dougsthenri/hub_usb_sd/README.md

# hub_usb_sd
PCB project for an SD card reader with 2-port USB hub and I²C bridge.

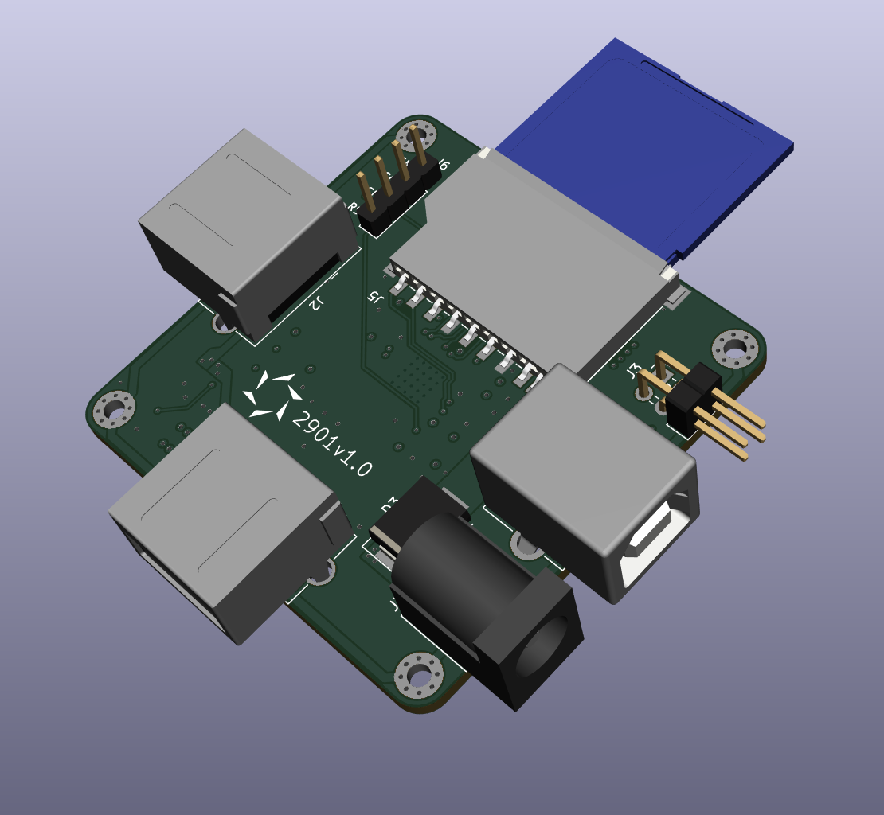
[picture p1: 2901.png]
PCB rendering
