dougsthenri/hub_usb_sd/hub_usb_sd.pdf

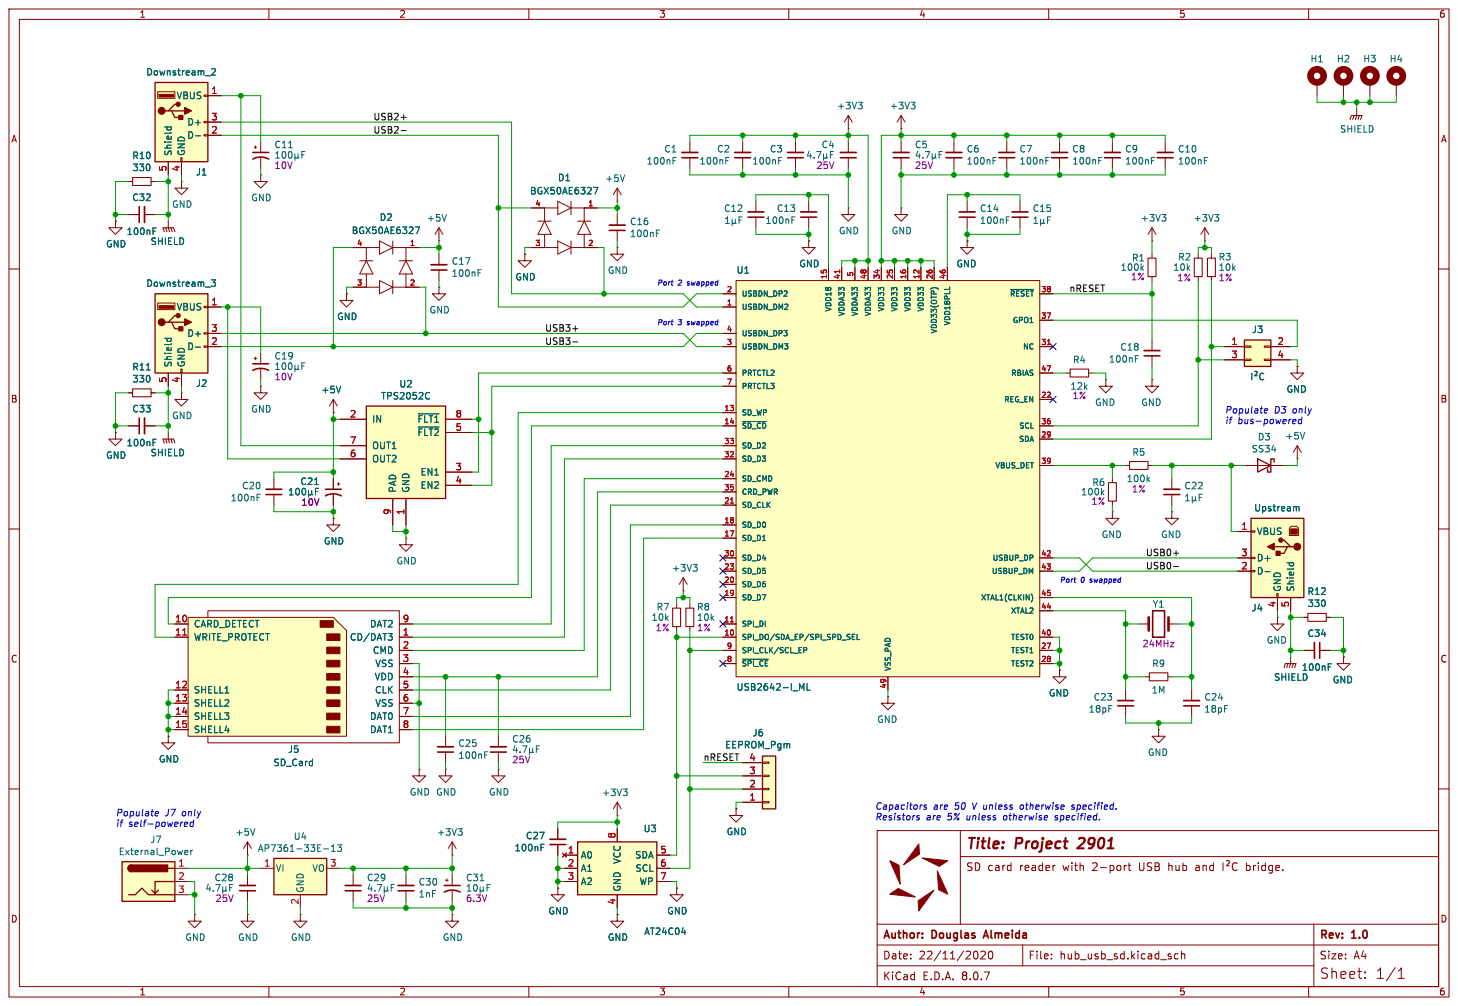
[picture p2: page 1]

4 SDA 5 SCL 6 WP 7 VCC
