dougsthenri/hub_usb_sd/hub_usb_sd.kicad_pcb

## KiCad design hub_usb_sd.kicad_pcb (2025-04-03)

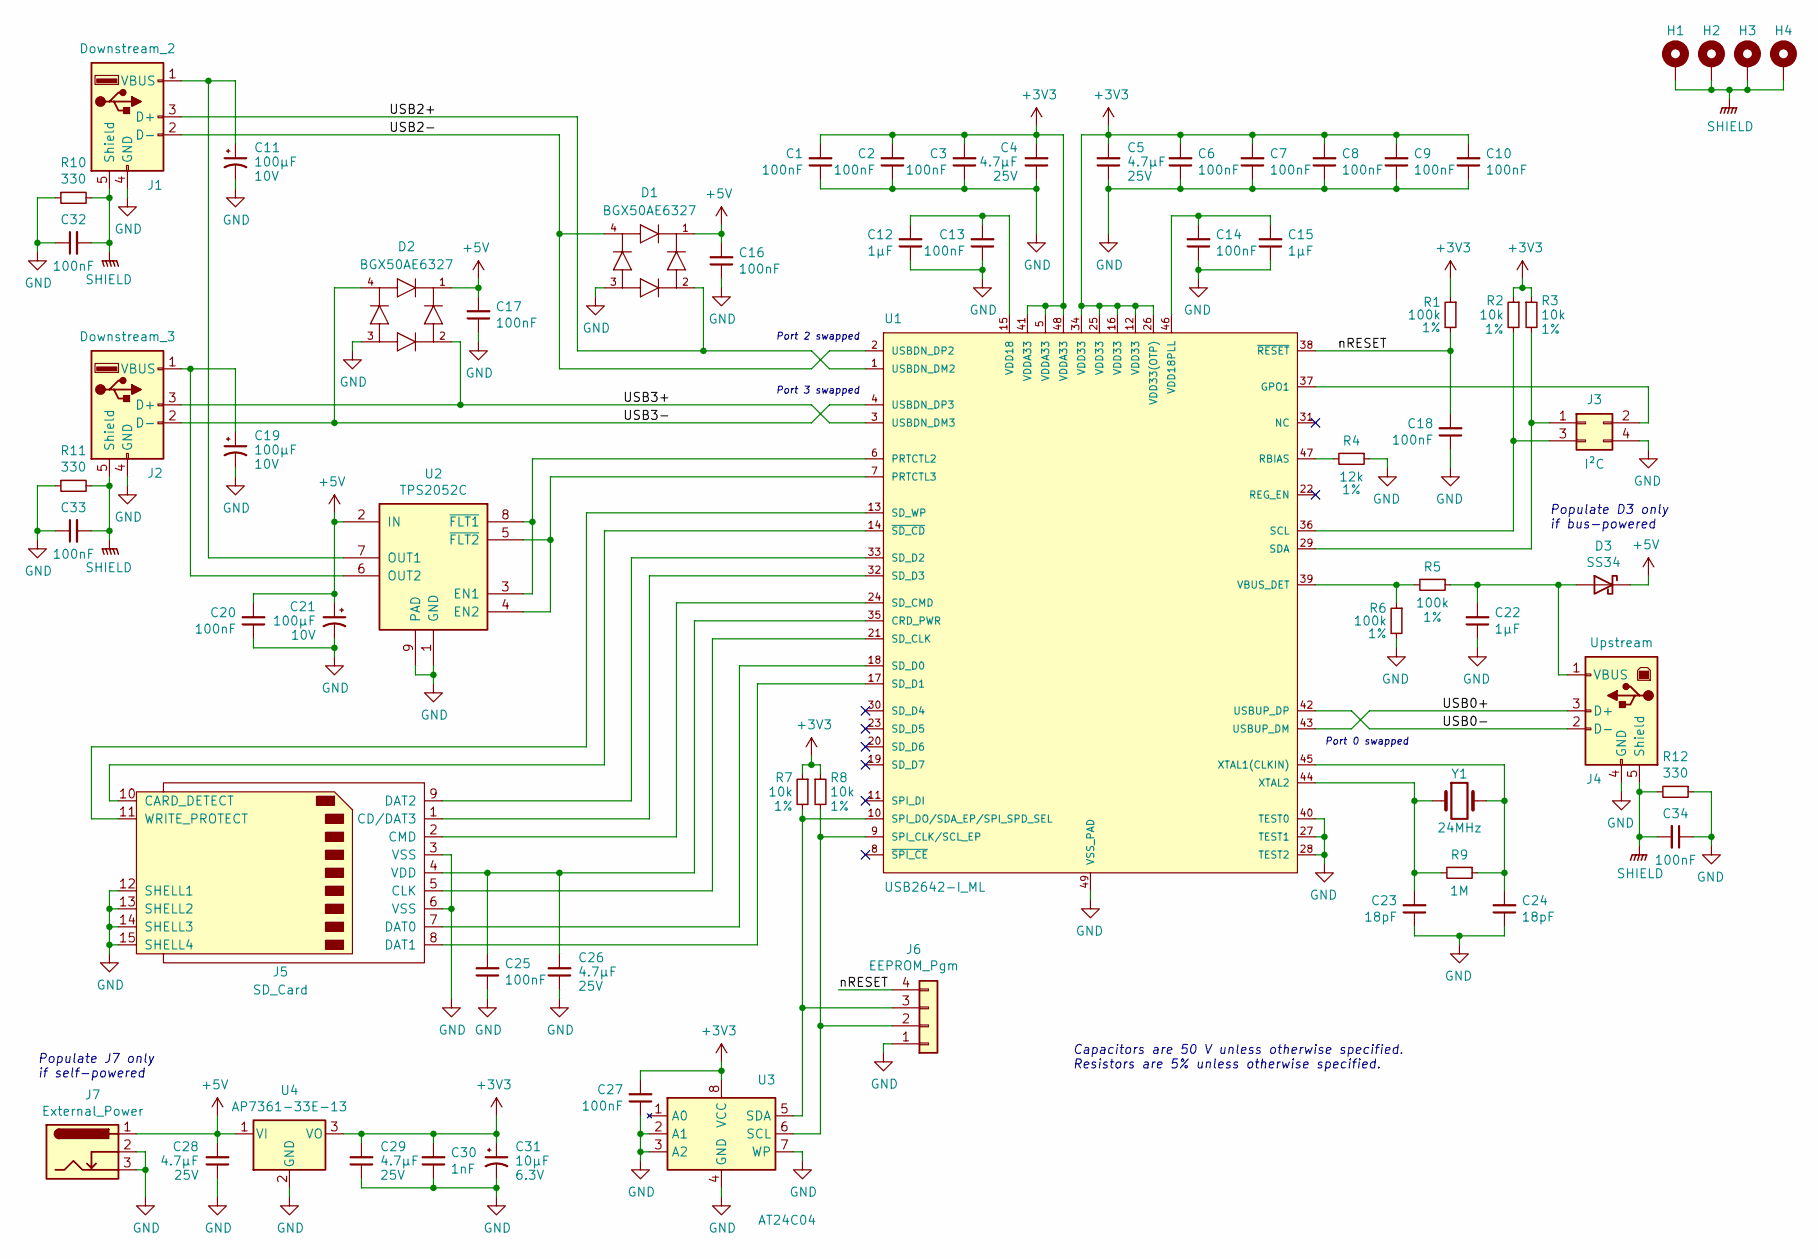
[picture p3: schematic hub_usb_sd.kicad_sch, Project 2901]

Parts:
C1, C2, C3, C6, C7, C8, C9, C10, C13, C14, C16, C17, C18, C20, C25, C27: 100nF; C_0805_2012Metric; Part# C0805C104K5RACTU
C4, C5, C26, C28, C29: 4.7µF; C_0805_2012Metric; Part# 08054,7UF25V
C11, C19, C21: 100µF; CP_EIA-3528-21_Kemet-B; Voltage 10V; Part# TMCMB1A107MTRF
C12, C15, C22: 1µF; C_0805_2012Metric; Part# 08051UF50V
C23, C24: 18pF; C_0603_1608Metric; Part# 060318PF50V
C30: 1nF; C_0603_1608Metric; Part# 06031NF50V
C31: 10µF; CP_EIA-3216-18_Kemet-A; Voltage 6.3V; Part# T491A106K006AT
C32, C33, C34: 100nF; C_0603_1608Metric; Part# 0603100NF50V
D1, D2: BGX50AE6327; Part# BGX 50A E6327
D3: SS34; D_SMC; Part# SS34
H1, H2, H3, H4: MountingHole_Pad; MountingHole_2.2mm_M2_Pad_Via
J1: Downstream_2; AF90_protruded_6_mm; Part# AF90
J2: Downstream_3; AF90_protruded_6_mm; Part# AF90
J3: I²C; PinHeader_2x02_P2.54mm_Horizontal_protruded_6_mm
J4: Upstream; USB_B_OST_USB-B1HSxx_Horizontal_Protruded_6_mm; Part# YH-USB03
J5: SD_Card; GCT_MEM1055-00-280-01-B; Part# 1138022
J6: EEPROM_Pgm; PinHeader_1x04_P2.54mm_Vertical
J7: External_Power; BarrelJack_DC-005_protruded_6_mm; Part# DC-005
R1, R5, R6: 100k; R_0805_2012Metric; Tolerance 1%; Part# CRCW0805100KFKEA
R2, R3, R7, R8: 10k; R_0805_2012Metric; Part# 08051%10K
R4: 12k; R_0805_2012Metric; Part# MC0805WAF1202T5E-TC
R9: 1M; R_0603_1608Metric; Part# 0603-1MOHM
R10, R11, R12: 330; R_0603_1608Metric; Part# 0603-330OHMS
U1: USB2642-I_ML; Microchip_USB2642-I_ML; Part# USB2642-I/ML-SEU
U2: TPS2052C; TI_DGN0008G; Part# TPS2052CDGNR
U3: AT24C04; Atmel_AT24C04BN; Part# AT24C04N-10SU-2.7
U4: AP7361-33E-13; SOT-223-3_TabPin2; Part# AP7361-33E-13
Y1: XRCGB24M000F0L00R0; Murata_XRCGB24M000F0L00R0; Part# XRCGB24M000F0L00R0

Connections:
+3V3: C1.2, C2.2, C3.2, C4.2, C5.2, C6.2, C7.2, C8.2, C9.2, C10.2, C27.2, C29.2, C30.2, C31.1, R1.1, R2.1, R3.1, R7.1, R8.1, U1.5 (VDDA33), U1.12 (VDD33), U1.16 (VDD33), U1.25 (VDD33), U1.26 (VDD33(OTP)), U1.34 (VDD33), U1.41 (VDDA33), U1.48 (VDDA33), U3.8 (VCC), U4.3 (VO)
+5V: C16.2, C17.2, C20.2, C21.1, C28.2, D1.1, D2.1, D3.1 (K), J7.1, U2.2 (IN), U4.1 (VI)
/USB0+: J4.3 (D+), U1.43 (USBUP_DM)
/USB0-: J4.2 (D-), U1.42 (USBUP_DP)
/USB2+: D1.2, J1.3 (D+), U1.1 (USBDN_DM2)
/USB2-: D1.4, J1.2 (D-), U1.2 (USBDN_DP2)
/USB3+: D2.2, J2.3 (D+), U1.3 (USBDN_DM3)
/USB3-: D2.4, J2.2 (D-), U1.4 (USBDN_DP3)
/nRESET: C18.2, J6.4, R1.2, U1.38 (~RESET)
GND: C1.1, C2.1, C3.1, C4.1, C5.1, C6.1, C7.1, C8.1, C9.1, C10.1, C11.2, C12.1, C13.1, C14.1, C15.1, C16.1, C17.1, C18.1, C19.2, C20.1, C21.2, C22.1, C23.1, C24.1, C25.1, C26.1, C27.1, C28.1, C29.1, C30.1, C31.2, C32.1, C33.1, C34.1, D1.3, D2.3, J1.4 (GND), J2.4 (GND), J3.4, J4.4 (GND), J5.3 (VSS), J5.6 (VSS), J5.12 (SHELL1), J5.13 (SHELL2), J5.14 (SHELL3), J5.15 (SHELL4), J6.1, J7.2, J7.3, R4.1, R6.2, R10.1, R11.1, R12.1, U1.27 (TEST1), U1.28 (TEST2), U1.40 (TEST0), U1.49 (VSS_PAD), U2.1 (GND), U2.9 (PAD), U3.2 (A1), U3.3 (A2), U3.4 (GND), U3.7 (WP), U4.2 (GND)
unnamed: C22.2, D3.2 (A), J4.1 (VBUS), R5.1
unnamed: C11.1, J1.1 (VBUS), U2.7 (OUT1)
unnamed: C19.1, J2.1 (VBUS), U2.6 (OUT2)
unnamed: J3.1, R3.2, U1.29 (SDA)
unnamed: J3.2, U1.37 (GPO1)
unnamed: J3.3, R2.2, U1.36 (SCL)
unnamed: J5.10 (CARD_DETECT), U1.14 (~SD_CD)
unnamed: J5.1 (CD/DAT3), U1.32 (SD_D3)
unnamed: J5.5 (CLK), U1.21 (SD_CLK)
unnamed: J5.2 (CMD), U1.24 (SD_CMD)
unnamed: J5.7 (DAT0), U1.18 (SD_D0)
unnamed: J5.8 (DAT1), U1.17 (SD_D1)
unnamed: J5.9 (DAT2), U1.33 (SD_D2)
unnamed: C25.2, C26.2, J5.4 (VDD), U1.35 (CRD_PWR)
unnamed: J5.11 (WRITE_PROTECT), U1.13 (SD_WP)
unnamed: J6.2, R8.2, U1.9 (SPI_CLK/SCL_EP), U3.6 (SCL)
unnamed: J6.3, R7.2, U1.10 (SPI_DO/SDA_EP/SPI_SPD_SEL), U3.5 (SDA)
unnamed: U1.6 (PRTCTL2), U2.3 (EN1), U2.8 (~FLT1)
unnamed: U1.7 (PRTCTL3), U2.4 (EN2), U2.5 (~FLT2)
unnamed: R4.2, U1.47 (RBIAS)
unnamed: R5.2, R6.1, U1.39 (VBUS_DET)
unnamed: C12.2, C13.2, U1.15 (VDD18)
unnamed: C14.2, C15.2, U1.46 (VDD18PLL)
unnamed: C24.2, R9.1, U1.45 (XTAL1(CLKIN)), Y1.3 (Crystal_terminal)
unnamed: C23.2, R9.2, U1.44 (XTAL2), Y1.1 (Crystal_terminal)
SHIELD: C32.2, C33.2, C34.2, H1.1, H2.1, H3.1, H4.1, J1.5 (Shield), J2.5 (Shield), J4.5 (Shield), R10.2, R11.2, R12.2

Notes on the sheet:
Port 0 swapped
Capacitors are 50 V unless otherwise specified. Resistors are 5% unless otherwise specified.
Port 3 swapped
Port 2 swapped
Populate D3 only if bus-powered
Populate J7 only if self-powered

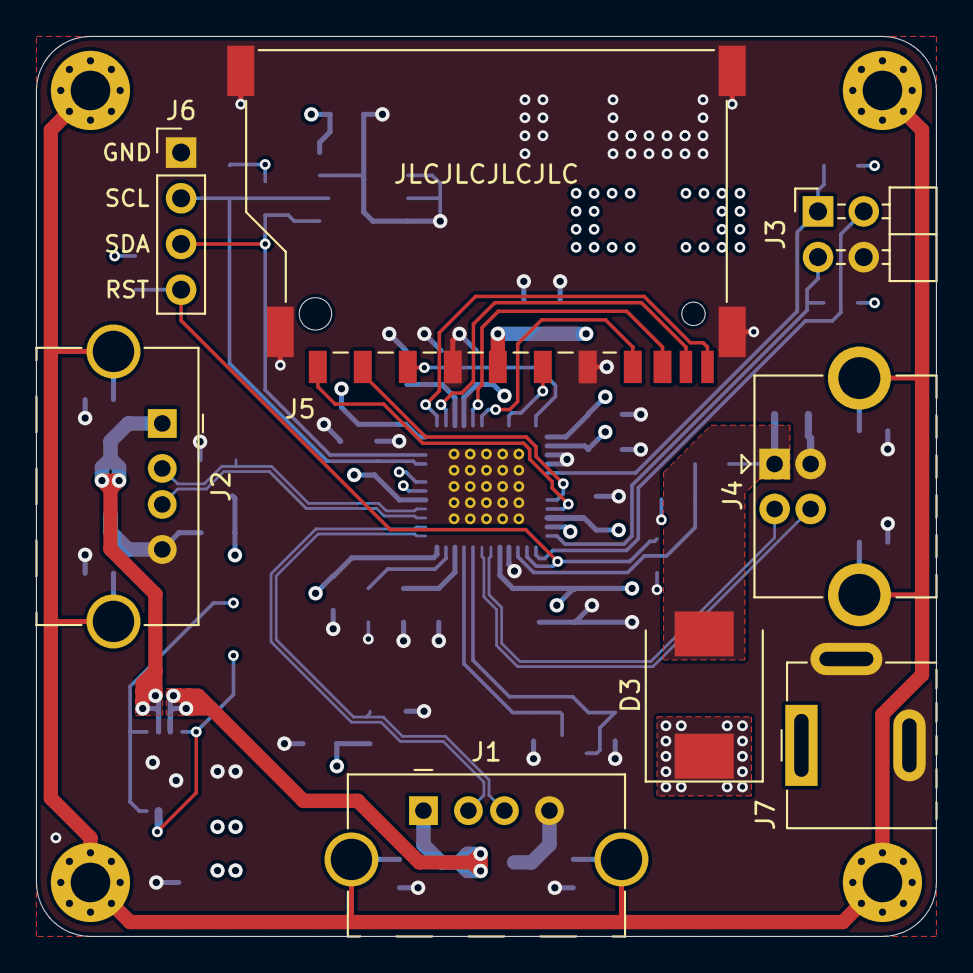
[picture p4: board hub_usb_sd.kicad_pcb from above]

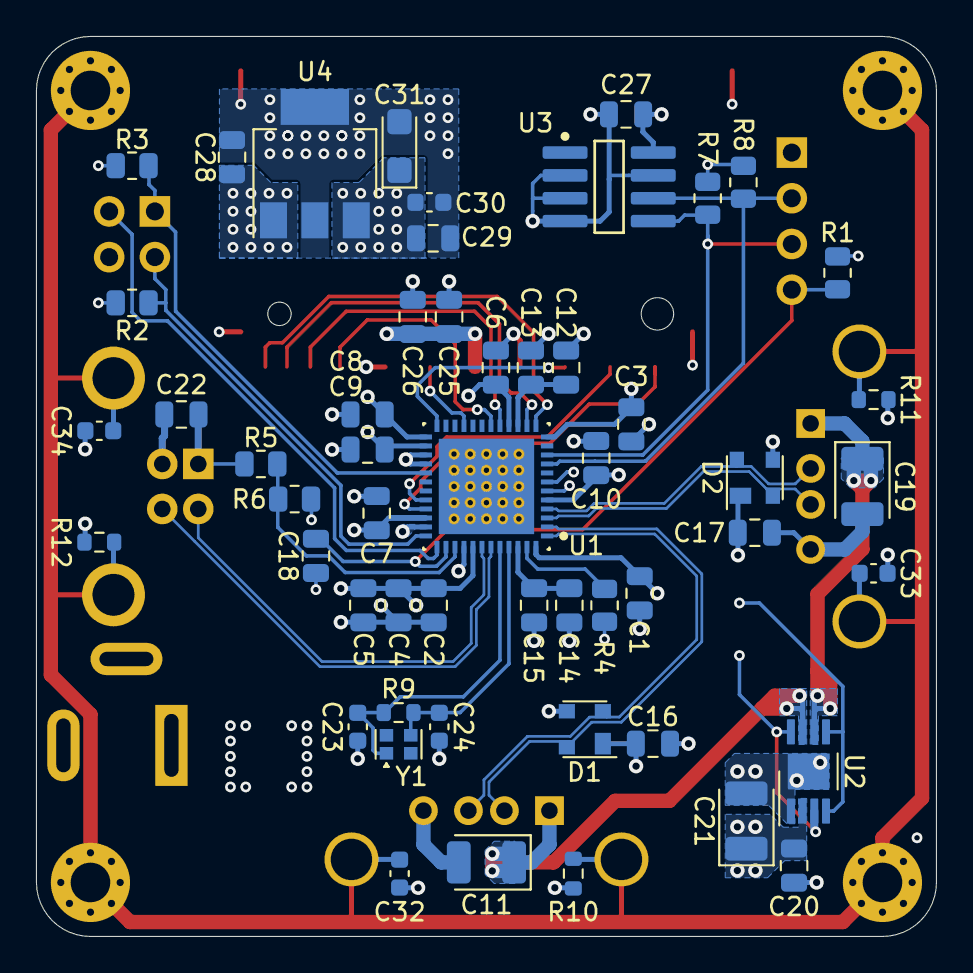
[picture p5: board hub_usb_sd.kicad_pcb from below]

Board: 4 copper layers, 50.0 x 50.0 mm, 65 parts (53 on the bottom side), 36 nets.
