dougsthenri/hub_usb_sd/(commit log)

2020-12-19 Added production remarks to schematic
    [hub_usb_sd.sch]
2020-12-20 Improved ground plane under U2 and corrected the positioning of C32-34
    [hub_usb_sd.kicad_pcb]
2020-12-21 Updated board layout to accommodate new power supply connector
    [hub_usb_sd-B_Cu.gbr, hub_usb_sd-B_Mask.gbr, hub_usb_sd-B_Paste.gbr, hub_usb_sd-B_SilkS.gbr, hub_usb_sd-Edge_Cuts.gbr, hub_usb_sd-F_Cu.gbr, hub_usb_sd-F_Mask.gbr, hub_usb_sd-F_Paste.gbr]
2020-12-21 Optimized trace under C18
    [hub_usb_sd.kicad_pcb]
2024-03-12 Upgraded project to Kicad 8.0. Defined part# fields. Further corrections pending
    [hub_usb_sd.kicad_pcb, hub_usb_sd.kicad_sch, hub_usb_sd.sch, hub_usb_sd_BOM.xls]
2025-03-24 Added PCB rendering image
2025-04-03 Reestructured repository for publishing on GitHub
    [hub_usb_sd.kicad_pcb, hub_usb_sd.kicad_sch]
